kamol-cpp/isort-color-sorting-conveyor/images/isort-conveyor.png

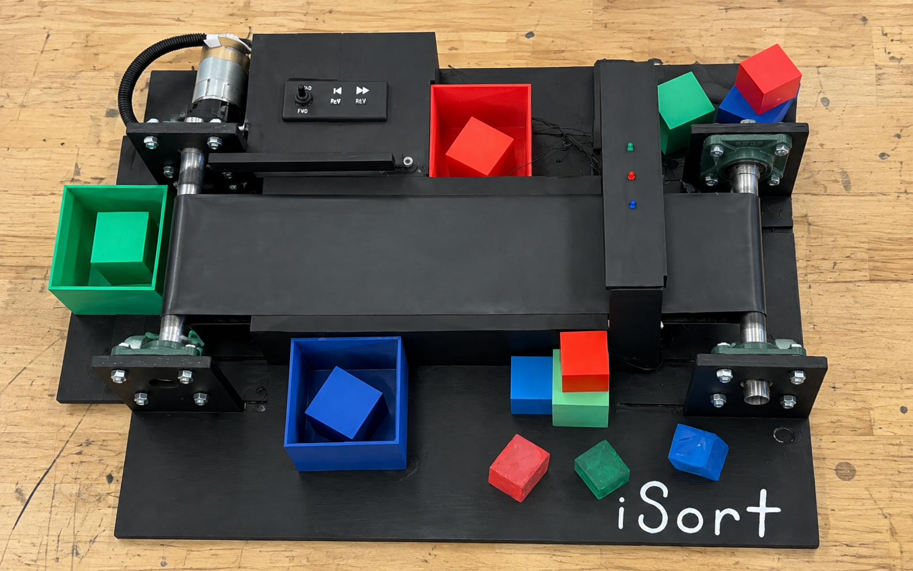
images/isort-conveyor.png
